sidechained/JoySpeak/images/corridor.jpg

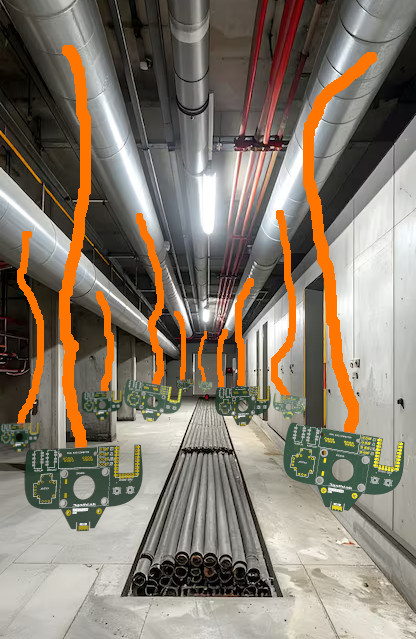
images/corridor.jpg
