sidechained/JoySpeak/images/JoySpeak1.png

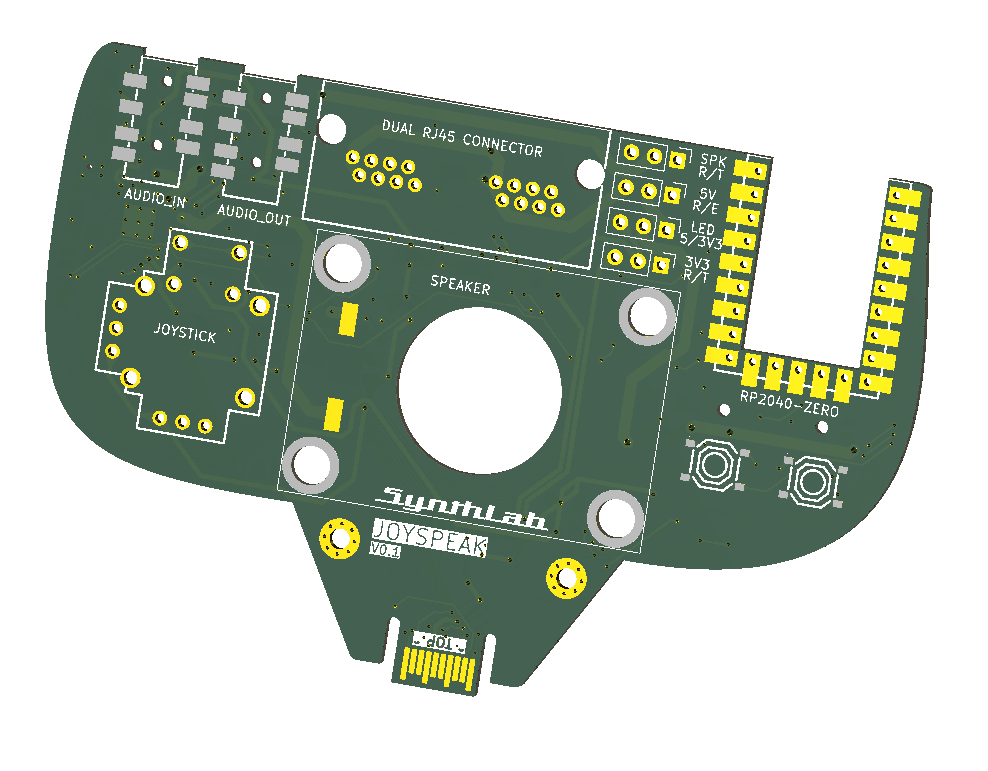
images/JoySpeak1.png
