sidechained/JoySpeak/images/PXL_20261004_211926107.jpg

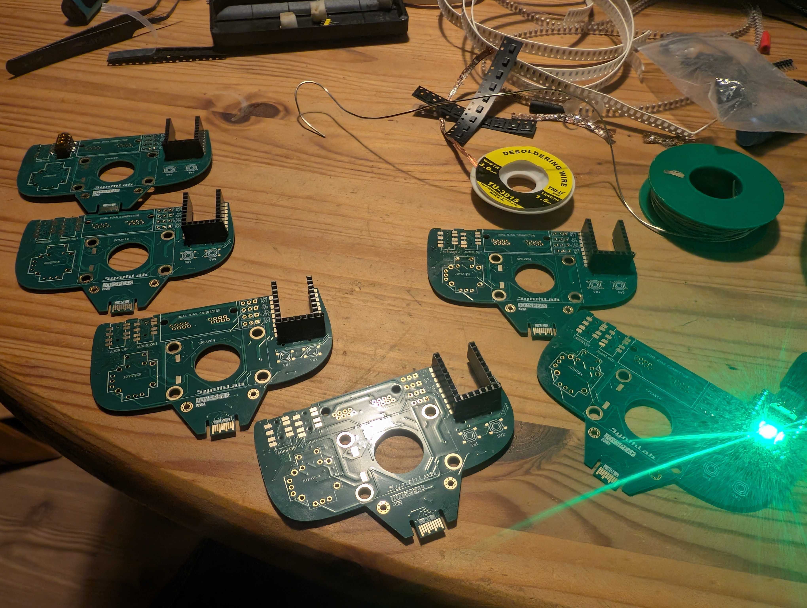
images/PXL_20261004_211926107.jpg
