sidechained/JoySpeak/images/PXL_20261010_090146171-sub.jpg

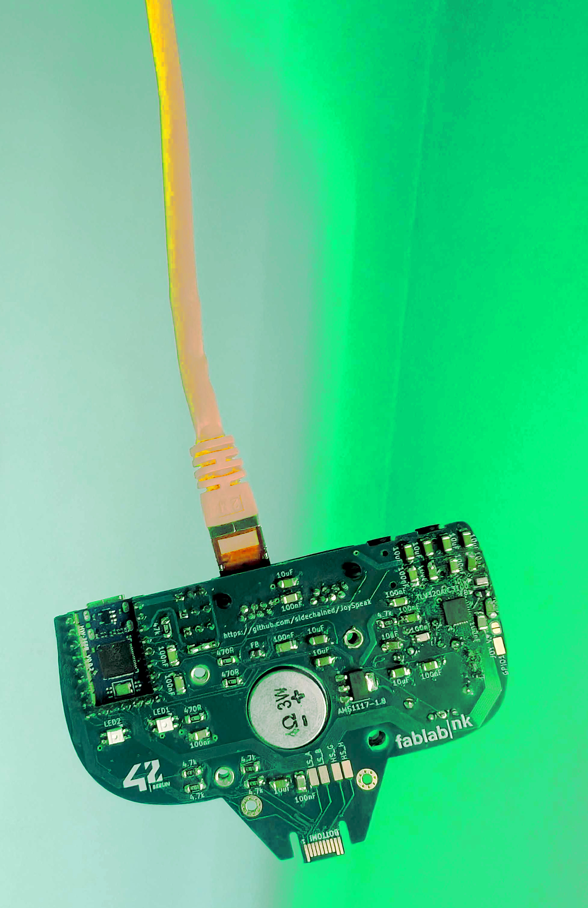
images/PXL_20261010_090146171-sub.jpg
