sidechained/JoySpeak/images/PXL_20261010_090221423-sub2.jpg

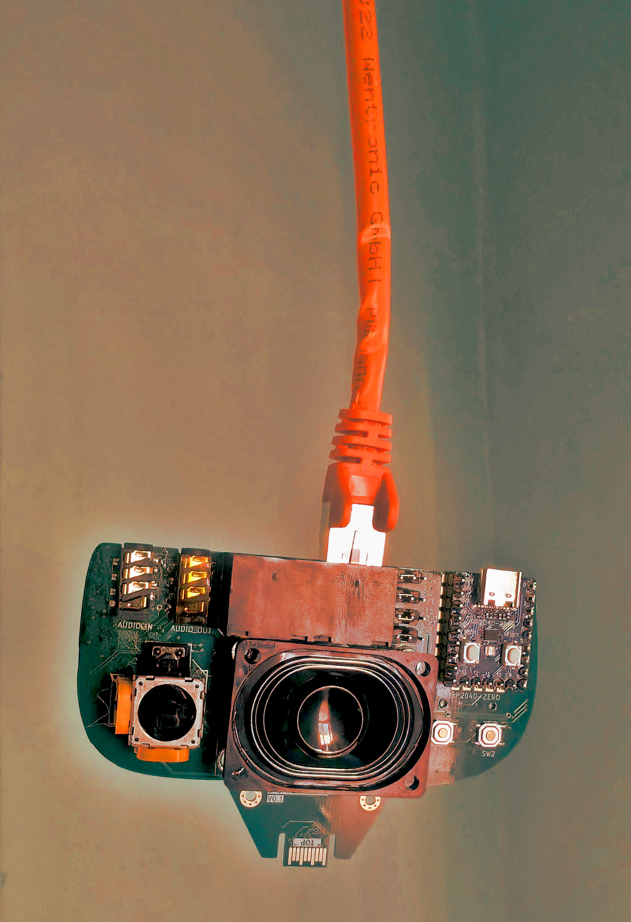
images/PXL_20261010_090221423-sub2.jpg
