sidechained/JoySpeak/notes/JoySpeak2ndBuildNotes.md

JoySpeak

Component,Status,Reason
C31 (10μF),DELETE,Duplicates C20 on +12V net
C28 (10μF),DELETE,Directly in parallel with C27 on +5V net
C26 (10μF),DELETE,Unnecessary output bulk cap before FB4
C24 (100nF),DELETE,Unnecessary input cap before FB3
FB3,DELETE,High-PSRR LDO does not need input ferrite filtering
FB4,DELETE,Cascaded LDOs don't need intermediate ferrite filtering
FB5,DELETE,Ferrite on buck converter input causes dangerous LC ringing

C20 (10μF),Required,KEEP (Bulk cable input)
C25 (100nF),Required,KEEP (U3 CIN)
C27 (10μF),Required,KEEP (U3 COUT / U2 CIN)
C32 (10μF),Required,KEEP (U4 CIN)
C30 + C68 (2×10μF),Required,KEEP BOTH (U4 needs ∼20μF output cap)
C29 (10μF),Required,KEEP (U2 COUT)

Place C27 physically within 1–2mm of U2 Pin 1 (IN).
Route the 5V line from U3 Pin 5 (OUT), across the 15mm distance, directly into C27, and then into U2.

TPS62902 has an Absolute Maximum rating of $+20\text{V}$, a $+24\text{V}$ transient spike will instantly destroy the internal silicon gate oxide or trigger a destructive latch-up.

1. Add LC Damping (The Most Critical Fix)You must damp the high-$Q$ resonance of the ceramic input capacitors.
