sidechained/JoySpeak/kicad/_restore_backup_2026-06-23T23-34-42-717/JoySpeak.kicad_pcb

## KiCad design kicad/_restore_backup_2026-06-23T23-34-42-717/JoySpeak.kicad_pcb (2026-06-23)

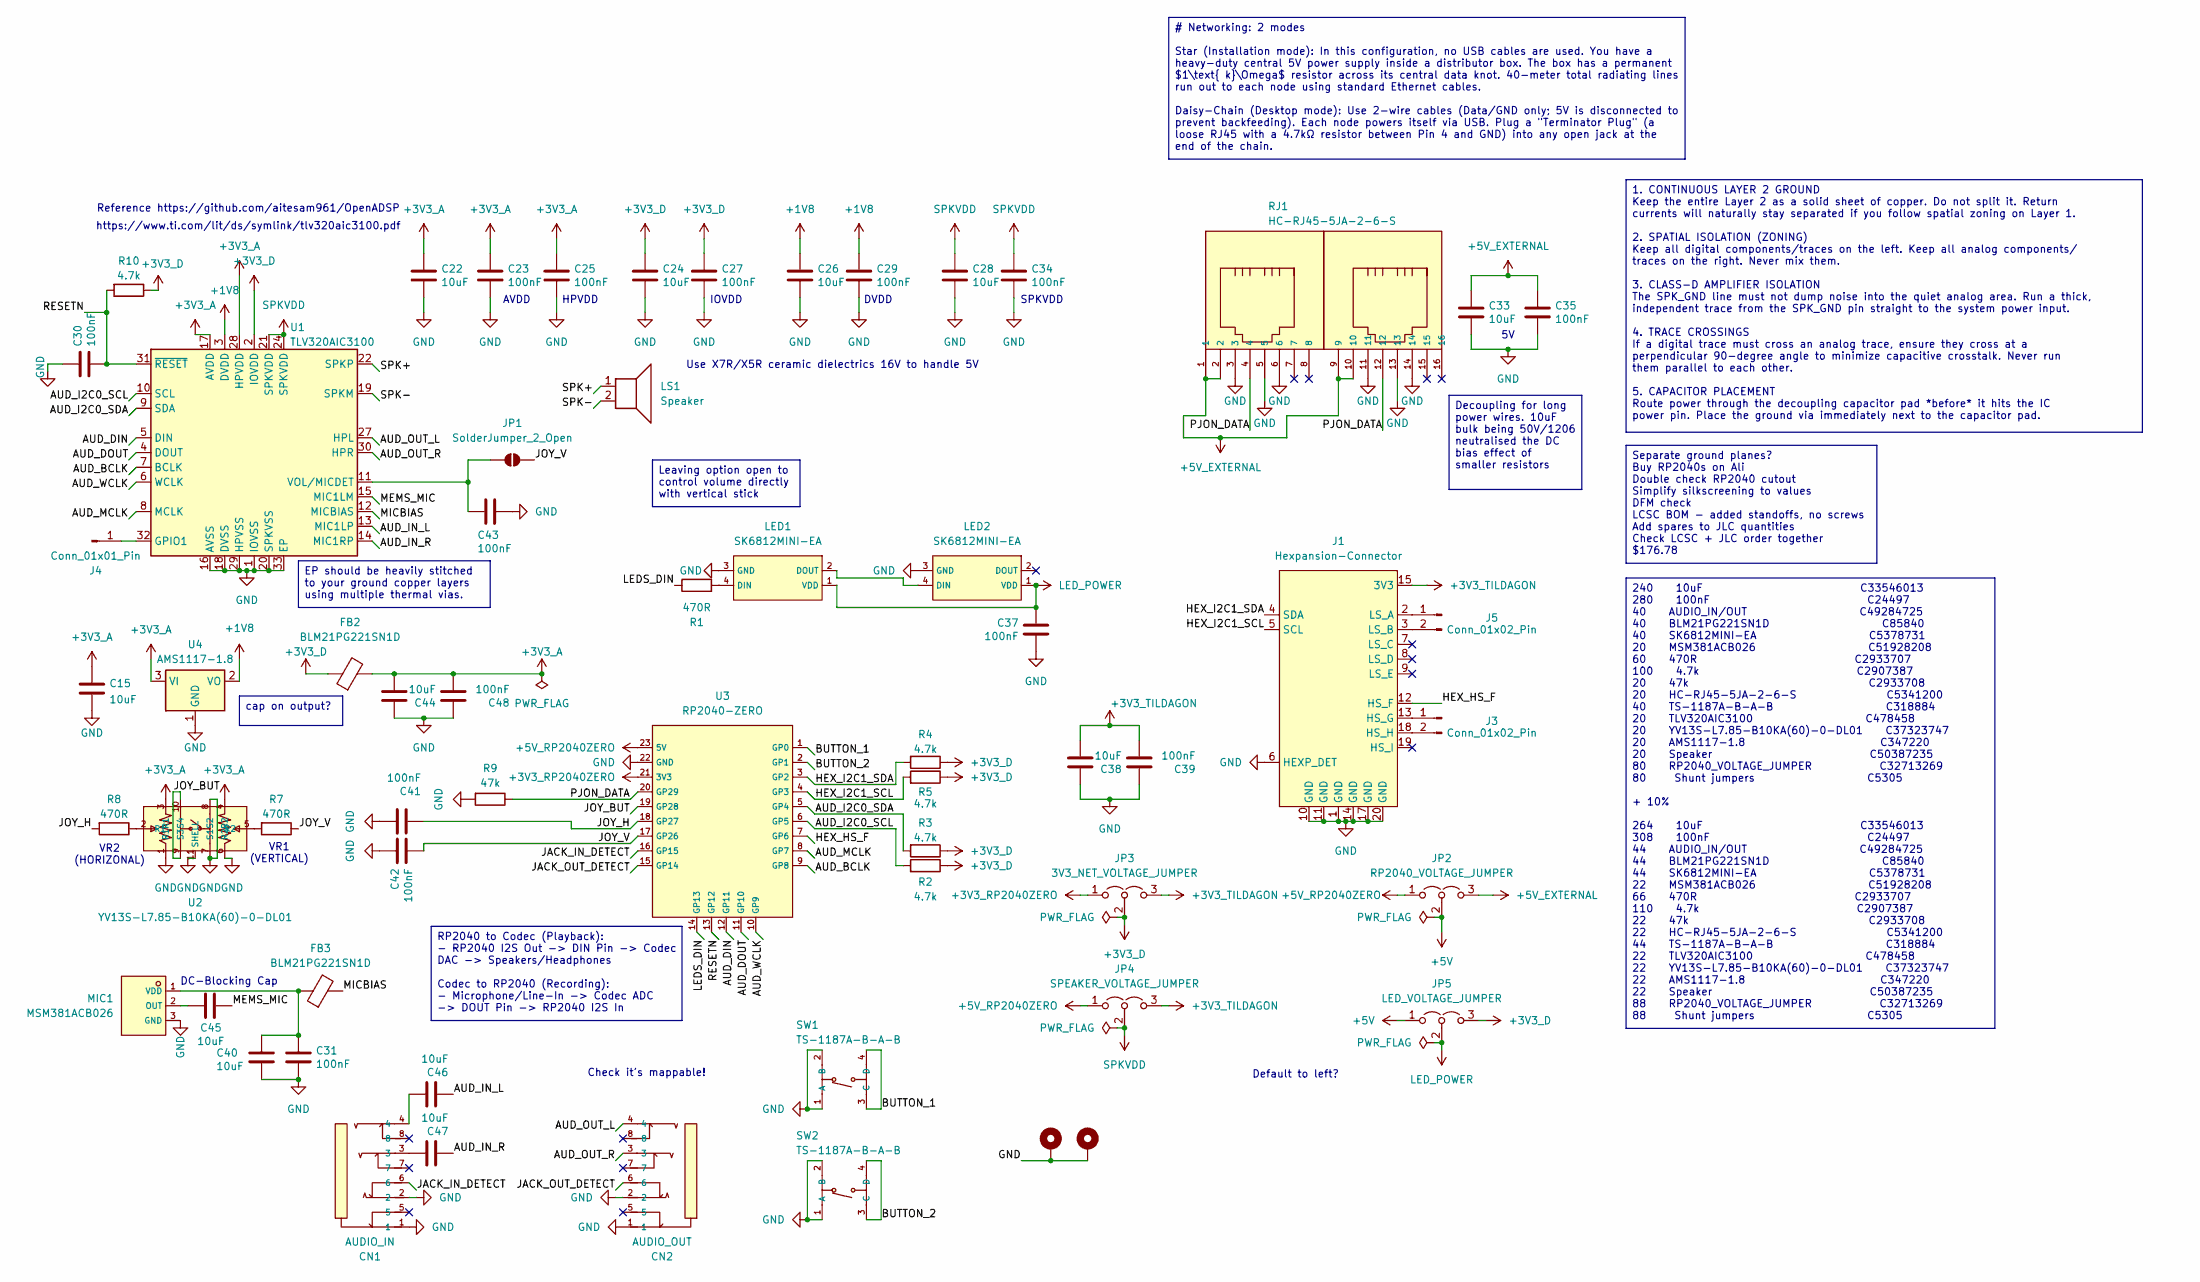
[picture p7: schematic JoySpeak.kicad_sch]

Parts:
C15, C22, C24, C26, C28, C33, C38, C40, C44, C45, C46, C47: 10uF; C_1206_3216Metric_Pad1.33x1.80mm_HandSolder; LCSC C33546013
C23, C25, C27, C29, C30, C31, C34, C35, C37, C39, C41, C42, C43, C48: 100nF; C_1206_3216Metric_Pad1.33x1.80mm_HandSolder; LCSC C24497
CN1: AUDIO_IN; C5155561_AUDIO-TH_PJ-393-8P; LCSC C49284725
CN2: AUDIO_OUT; C5155561_AUDIO-TH_PJ-393-8P; LCSC C49284725
FB2, FB3: BLM21PG221SN1D; L_0805_2012Metric_Pad1.05x1.20mm_HandSolder; LCSC C85840
H1, H2: MountingHole_Pad; MountingHole_2.2mm_M2_Pad_Via
J1: Hexpansion-Connector; hexpansion-edge-connector
J3, J5: Conn_01x02_Pin; HexpansionPads1x02
J4: Conn_01x01_Pin; HexpansionPads1x01
JP1: SolderJumper_2_Open; SolderJumper-2_P1.3mm_Open_RoundedPad1.0x1.5mm
JP2: RP2040_VOLTAGE_JUMPER; PinHeader_1x03_P2.54mm_Vertical; LCSC C32713269
JP3: 3V3_NET_VOLTAGE_JUMPER; PinHeader_1x03_P2.54mm_Vertical; LCSC C32713269
JP4: SPEAKER_VOLTAGE_JUMPER; PinHeader_1x03_P2.54mm_Vertical; LCSC C32713269
JP5: LED_VOLTAGE_JUMPER; PinHeader_1x03_P2.54mm_Vertical; LCSC C32713269
LED1, LED2: SK6812MINI-EA; C5378731_LED-SMD_4P-L3_2-W2_8_SK6812MINI-EA; LCSC C5378731
LS1: Speaker; Speaker_XHXDZ-2840-4Ω3W; LCSC C50387235
MIC1: MSM381ACB026; C51928208_MIC-SMD_L2_8-W1_9_MSM381ACB026; LCSC C51928208
R1, R7, R8: 470R; R_1206_3216Metric_Pad1.30x1.75mm_HandSolder; LCSC C2933707
R2, R3, R4, R5, R10: 4.7k; R_1206_3216Metric_Pad1.30x1.75mm_HandSolder; LCSC C2907387
R9: 47k; R_1206_3216Metric_Pad1.30x1.75mm_HandSolder; LCSC C2933708
RJ1: HC-RJ45-5JA-2-6-S; C5341200_RJ45-TH_HC-RJ45-5JA-2-6-S; LCSC C5341200
SW1, SW2: TS-1187A-B-A-B; C318884_SW-SMD_4P-L5_1-W5_1-P3_70-LS6_5-TL_H1_5; LCSC C318884
U1: TLV320AIC3100; VQFN-32-1EP_5x5mm_P0.5mm_EP3.5x3.5mm_ThermalVias; LCSC C478458
U2: YV13S-L7.85-B10KA(60)-0-DL01; C37323747_JOYTICK-TH_YV13S-L7_85-B10KA-60--0-DL01; LCSC C37323747
U3: RP2040-ZERO; C5350143_COMM-SMD_RP2040-ZERO
U4: AMS1117-1.8; SOT-223-3_TabPin2; LCSC C347220

Connections:
+1V8: C26.1, C29.1, U1.3 (DVDD), U4.2 (VO)
+3V3_A: C15.1, C22.1, C23.1, C25.1, C44.1, C48.1, FB2.2, U1.17 (AVDD), U1.28 (HPVDD), U2.3 (R1), U2.4 (R2), U4.3 (VI)
+3V3_D: C24.1, C27.1, FB2.1, JP3.2 (C), JP5.3 (B), R2.1, R3.1, R4.1, R5.1, R10.1, U1.2 (IOVDD)
+3V3_RP2040ZERO: JP3.1 (A), U3.21 (3V3)
+3V3_TILDAGON: C38.1, C39.1, J1.15 (3V3), J1.16 (3V3), JP3.3 (B), JP4.3 (B)
+5V: JP2.2 (C), JP5.1 (A)
+5V_EXTERNAL: C33.1, C35.1, JP2.3 (B), RJ1.1, RJ1.2, RJ1.9, RJ1.10
+5V_RP2040ZERO: JP2.1 (A), JP4.1 (A), U3.23 (5V)
/AUD_BCLK: U1.7 (BCLK), U3.9 (GP8)
/AUD_DIN: U1.5 (DIN), U3.12 (GP11)
/AUD_DOUT: U1.4 (DOUT), U3.11 (GP10)
/AUD_I2C0_SCL: R2.2, U1.10 (SCL), U3.6 (GP5)
/AUD_I2C0_SDA: R3.2, U1.9 (SDA), U3.5 (GP4)
/AUD_IN_L: C46.2, U1.13 (MIC1LP)
/AUD_IN_R: C47.2, U1.14 (MIC1RP)
/AUD_MCLK: U1.8 (MCLK), U3.8 (GP7)
/AUD_OUT_L: CN2.4, U1.27 (HPL)
/AUD_OUT_R: CN2.3, U1.30 (HPR)
/AUD_WCLK: U1.6 (WCLK), U3.10 (GP9)
/BUTTON_1: SW1.3 (C), SW1.4 (D), U3.1 (GP0)
/BUTTON_2: SW2.3 (C), SW2.4 (D), U3.2 (GP1)
/HEX_HS_F: J1.12 (HS_F), U3.7 (GP6)
/HEX_I2C1_SCL: J1.5 (SCL), R5.2, U3.4 (GP3)
/HEX_I2C1_SDA: J1.4 (SDA), R4.2, U3.3 (GP2)
/JACK_IN_DETECT: CN1.6, U3.16 (GP15)
/JACK_OUT_DETECT: CN2.6, U3.15 (GP14)
/JOY_BUT: U2.9 (S3), U2.10 (S4), U3.19 (GP28)
/JOY_H: C41.2, R8.2, U3.18 (GP27)
/JOY_V: C42.2, JP1.2 (B), R7.1, U3.17 (GP26)
/LEDS_DIN: R1.1, U3.14 (GP13)
/MEMS_MIC: C45.1, U1.15 (MIC1LM)
/MICBIAS: FB3.2, U1.12 (MICBIAS)
/PJON_DATA: R9.1, RJ1.4, RJ1.12, U3.20 (GP29)
/RESETN: C30.2, R10.2, U1.31 (~RESET), U3.13 (GP12)
/SPK+: LS1.1 (+), U1.22 (SPKP), U1.26 (SPKP)
/SPK-: LS1.2 (-), U1.19 (SPKM), U1.23 (SPKM)
GND: C15.2, C22.2, C23.2, C24.2, C25.2, C26.2, C27.2, C28.2, C29.2, C30.1, C31.2, C33.2, C34.2, C35.2, C37.2, C38.2, C39.2, C40.2, C41.1, C42.1, C43.1, C44.2, C48.2, CN1.1, CN1.2, CN2.1, CN2.2, H1.1 (1_1), H2.1 (1_1), J1.1 (GND), J1.6 (HEXP_DET), J1.10 (GND), J1.11 (GND), J1.14 (GND), J1.17 (GND), J1.20 (GND), LED1.3 (GND), LED2.3 (GND), MIC1.3 (GND), R9.2, RJ1.3, RJ1.5, RJ1.6, RJ1.11, RJ1.13, RJ1.14, SW1.1 (A), SW1.2 (B), SW2.1 (A), SW2.2 (B), U1.1 (IOVSS), U1.16 (AVSS), U1.18 (DVSS), U1.20 (SPKVSS), U1.25 (SPKVSS), U1.29 (HPVSS), U1.33 (EP), U2.1 (R1), U2.6 (R2), U2.7 (S1), U2.8 (S2), U2.11 (SHELL), U3.22 (GND), U4.1 (GND)
LED_POWER: C37.1, JP5.2 (C), LED1.1 (VDD), LED2.1 (VDD)
unnamed: C46.1, CN1.4
unnamed: C47.1, CN1.3
unnamed: J1.13 (HS_G), J3.1
unnamed: J1.18 (HS_H), J3.2
unnamed: J1.2 (LS_A), J5.1
unnamed: J1.3 (LS_B), J5.2
unnamed: J4.1 (Pin_1_1), U1.32 (GPIO1)
unnamed: C43.2, JP1.1 (A), U1.11 (VOL/MICDET)
unnamed: LED1.4 (DIN), R1.2
unnamed: LED1.2 (DOUT), LED2.4 (DIN)
unnamed: C45.2, MIC1.2 (OUT)
unnamed: C31.1, C40.1, FB3.1, MIC1.1 (VDD)
unnamed: R7.2, U2.5 (R2)
unnamed: R8.1, U2.2 (R1)
SPKVDD: C28.1, C34.1, JP4.2 (C), U1.21 (SPKVDD), U1.24 (SPKVDD)

Notes on the sheet:
Default to left?
IOVDD
HPVDD
Reference https://github.com/aitesam961/OpenADSP
Use X7R/X5R ceramic dielectrics 16V to handle 5V
VR2 (HORIZONAL)
VR1 (VERTICAL)
AVDD
DVDD
https://www.ti.com/lit/ds/symlink/tlv320aic3100.pdf
SPKVDD
Check it's mappable!
DC-Blocking Cap
Decoupling for long power wires. 10uF bulk being 50V/1206 neutralised the DC bias effect of smaller resistors
EP should be heavily stitched to your ground copper layers using multiple thermal vias.
RP2040 to Codec (Playback): - RP2040 I2S Out -> DIN Pin -> Codec DAC -> Speakers/Headphones Codec to RP2040 (Recording): - Microphone/Line-In -> Codec ADC -> DOUT Pin -> RP2040 I2S In
cap on output?
Leaving option open to control volume directly with vertical stick
Separate ground planes? Buy RP2040s on Ali Double check RP2040 cutout Simplify silkscreening to values DFM check LCSC BOM - added standoffs, no screws Add spares to JLC quantities Check LCSC + JLC order together $176.78
# Networking: 2 modes Star (Installation mode): In this configuration, no USB cables are used. You have a heavy-duty central 5V power supply inside a distributor box. The box has a permanent $1\text{ k}\Omega$ resistor across its central data knot. 40-meter total radiating lines run out to each nod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
1. CONTINUOUS LAYER 2 GROUND Keep the entire Layer 2 as a solid sheet of copper. Do not split it. Return currents will naturally stay separated if you follow spatial zoning on Layer 1. 2. SPATIAL ISOLATION (ZONING) Keep all digital components/traces on the left. Keep all analog components/ traces o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
240 10uF C33546013 280 100nF C24497 40 AUDIO_IN/OUT C49284725 40 BLM21PG221SN1D C85840 40 SK6812MINI-EA C5378731 20 MSM381ACB026 C51928208 60 470R C2933707 100 4.7k C2907387 20 47k C2933708 20 HC-RJ45-5JA-2-6-S C5341200 40 TS-1187A-B-A-B C318884 20 TLV320AIC3100 C478458 20 YV13S-L7.85-B10KA(60)-0-D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

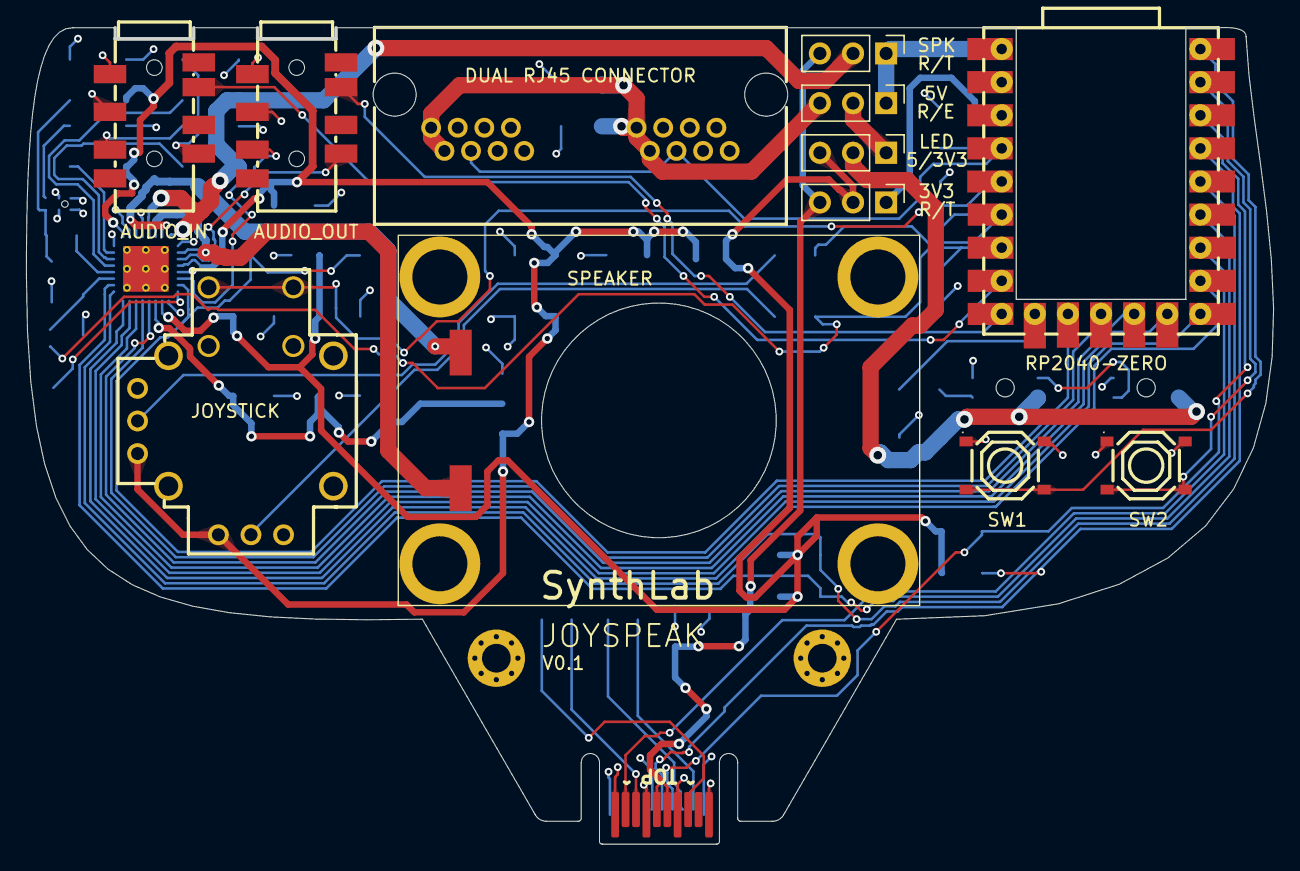
[picture p8: board JoySpeak.kicad_pcb from above]

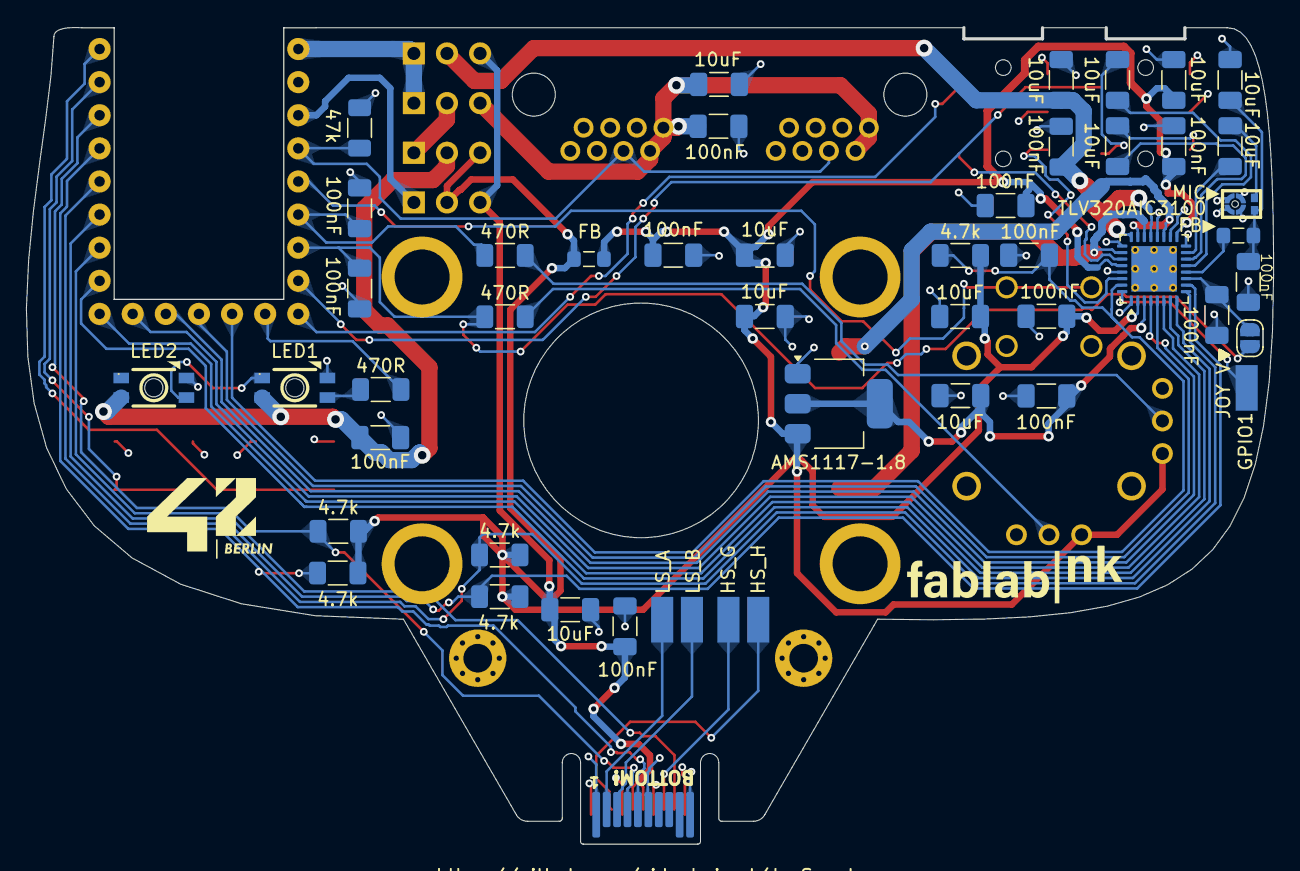
[picture p9: board JoySpeak.kicad_pcb from below]

Board: 4 copper layers, 95.7 x 62.6 mm, 61 parts (46 on the bottom side), 53 nets.
