sidechained/JoySpeak/(commit log)

2026-06-14 Commiting before moving from CAN to PJON
    [JoySpeak.kicad_pcb, JoySpeak.kicad_sch]
2026-06-19 Commiting before simplification
    [JoySpeak.kicad_pcb, JoySpeak.kicad_sch, bom.csv, designators.csv, positions.csv]
2026-06-19 Started jumpering power. Consolidated cap and resistor values
    [JoySpeak.kicad_sch]
2026-06-20 Attempted test routing - saving before making layout changes
    [JoySpeak.kicad_pcb, JoySpeak.kicad_sch, bom.csv, designators.csv, positions.csv]
2026-06-21 Closing in - commiting before adding teardrops
    [JoySpeak.kicad_pcb, JoySpeak.kicad_sch, bom.csv, designators.csv, positions.csv]
2026-06-21 Committing before flipping RJ45 connector
    [JoySpeak.csv, JoySpeak.kicad_pcb, JoySpeak.kicad_sch, bom.csv, positions.csv]
2026-06-22 Committing before attempting 4-layer layout
    [JoySpeak.kicad_pcb, JoySpeak.kicad_sch]
2026-06-23 Fixed all DRC errors
    [JoySpeak.kicad_pcb, JoySpeak.kicad_sch]
2026-06-23 Finalised, pass DFM and sent for fabrication (JLCPCB)
    [JoySpeak.csv, JoySpeak.kicad_pcb, JoySpeak.kicad_sch, bom.csv, designators.csv, positions.csv]
